fitzterra/kossel/BOM.ods

Kossel Bill of Materials
Printed Parts
Part | Qty | Cost | Done
Bottom Frame | 3 |  | 3
Top Frame | 3 |  | 3
Carriage | 3 |  | 3
Tower Slider | 3 |  | 3
Rod End Connectors | 12 |  | 12
Endstop | 3 |  | 3
End Effector | 1
Extruder | 1
Z-Probe | 1
Glass Tabs | 3
Rail Carriage | 3
Frame
Part – Mini | Qty | Cost | Done
600mm OpenBeam | 3
240mm OpenBeam | 9 |  |  |  | Lengths of 2m 1515 OpenBeam needed for XL
Borosilicate glass (170mm round) | 1 |  |  |  | Length | 650 | Remainder
 |  |  |  |  | 2000 | 3 | 50
Part – XL | Qty | Cost | Done |  | 2000 | 0 | 2000
650 mm OpenBeam (XL uses 750) | 3 | 0 | 3 | Ordered from Communica on 27/01/2015. Should be here by 10/02 |  | 360
360 mm OpenBeam | 9 | 982.6 | 9 |  | 2000 | 5 | 200
Borosilicate glass (250mm round) | 1 |  |  |  | 1250 | 3 | 170
 |  |  |  |  | 2000 | 5 | 200
Nuts & Bolts |  |  |  |  | 3 lengths @ R310/length from Communica
M2.5×12 | 1
M2.5×16 (plus 1 spare) | 10
M3×6 (you can do with half but this is for every hole) | 50
M3×8 (you need about 63 so enough spares) | 100
M3×16 (plus 1 spare) | 1
M3×20 (plus 2 spare) | 6
M3×25 (plus 3 spare) | 12
M3×35 (we don’t use it for tensioning but you may choose to do otherwise) | 3
M3 Nut (you need most of them) | 100
M3 Nyloc nut (plus 1 spare) | 1
M3 washer (you need about 60 of them) | 100
M4×20 grub screw (plus 3 spare) | 12
M5×20 | 1
M5 Nyloc nut | 1
M5 washer | 1
Linear Motion
Dual 623 V-rollers | 9
GT2 belt +-1400mm per slide | 3 | 76.5 | 3
GT2 Idler Wheel ( http://builda3dprinter.eu uses 2 x F623ZZ flanged bearings) | 3 | 105.3 | 3
GT2 Pulley 20 Teeth (16 teeth in kits from http://builda3dprinter.eu) | 3 | 42 | 3
NEMA17 stepper motor | 3 | 815.61 | 3
Diagonal Push Rods
Carbon Fibre rods – ID:4mm, OD:6mm, L:280mm | 6 | 270 | 6
Traxxas 5347 Ball ends | 12 | 73 | 12
Bowden Extruder
Hot End
Elecronics
Geetech GT2560 + DRV8825 Driver + LCD2004 Kit | 1 | 700
Fastners
M3 x 8 nut | 50 | 6.5
M3 x 8 hex bolt | 50 | 9
