fitzterra/kossel/stl.origs/extruder.stl

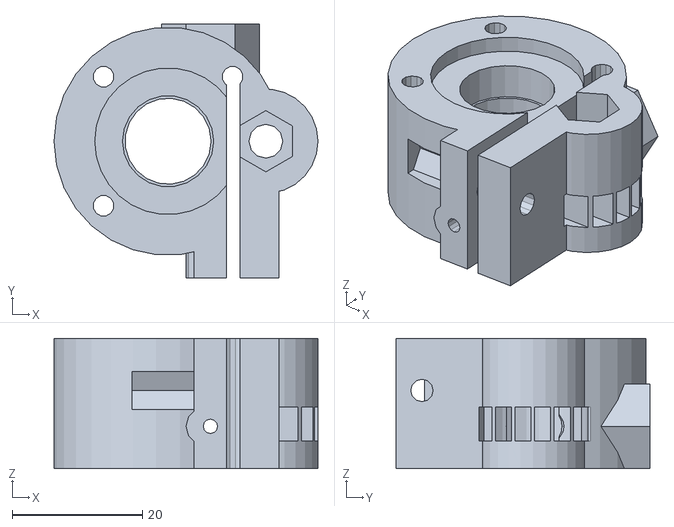
[picture p1: CAD file, 2016-03-02]
stl.origs/extruder.stl
40.5 x 39.0 x 20.0
