fitzterra/kossel/vbuild/ExtruderMotorBowdenMount.stl

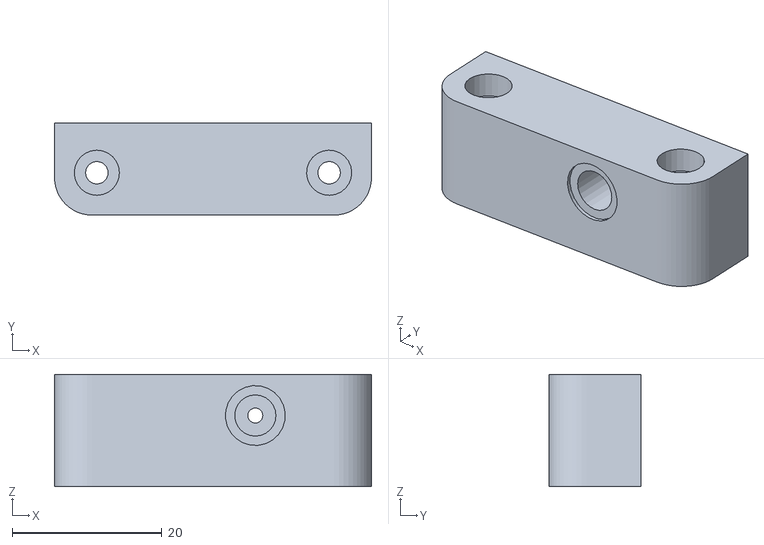
[picture p2: CAD file, 2017-05-16]
vbuild/ExtruderMotorBowdenMount.stl
42.3 x 12.3 x 15.0
