fitzterra/kossel/stl.origs/switch_holder.stl

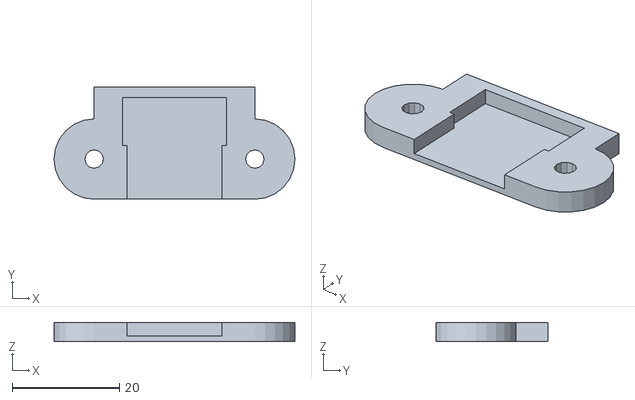
[picture p3: CAD file, 2016-03-02]
stl.origs/switch_holder.stl
45.0 x 21.0 x 3.60
