fitzterra/kossel/vbuild/ControlKnob.stl

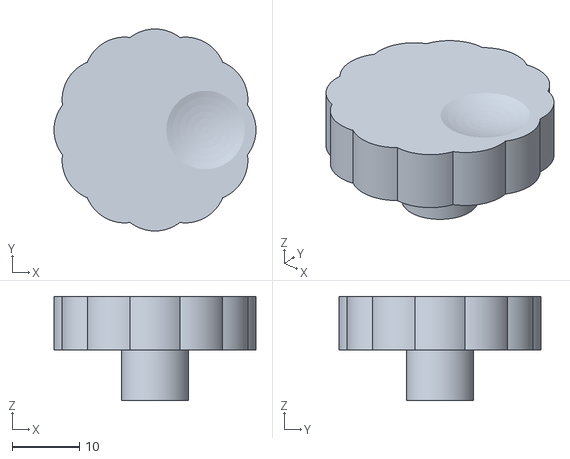
[picture p4: CAD file, 2017-05-16]
vbuild/ControlKnob.stl
30.0 x 30.0 x 15.5
