fitzterra/kossel/stl.origs/glass_frame.stl

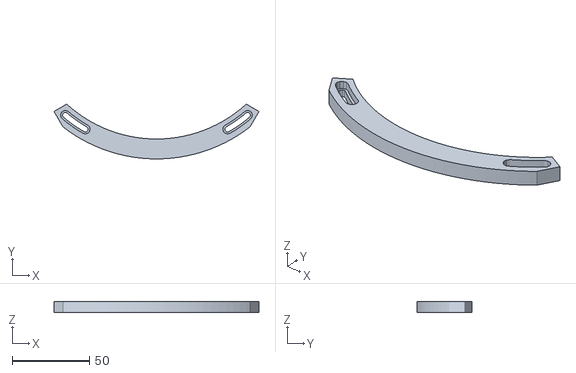
[picture p5: CAD file, 2016-03-02]
stl.origs/glass_frame.stl
132.8 x 35.5 x 7.35
