fitzterra/kossel/vbuild/EndstopWireGuide.stl

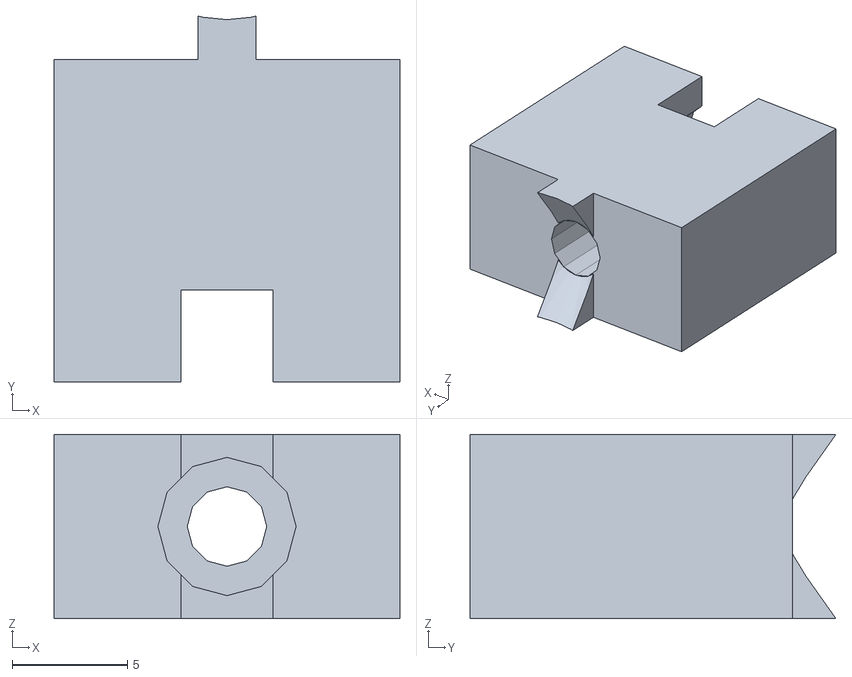
[picture p6: CAD file, 2016-06-09]
vbuild/EndstopWireGuide.stl
15.0 x 15.9 x 8.00
