fitzterra/kossel/stl.origs/card.stl

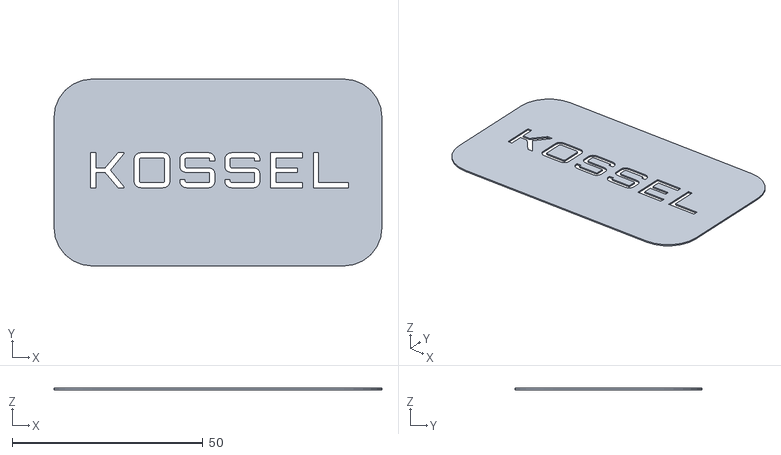
[picture p7: CAD file, 2016-03-02]
stl.origs/card.stl
86.0 x 49.0 x 0.4
