fitzterra/kossel/vbuild/rod_connector_hex.stl

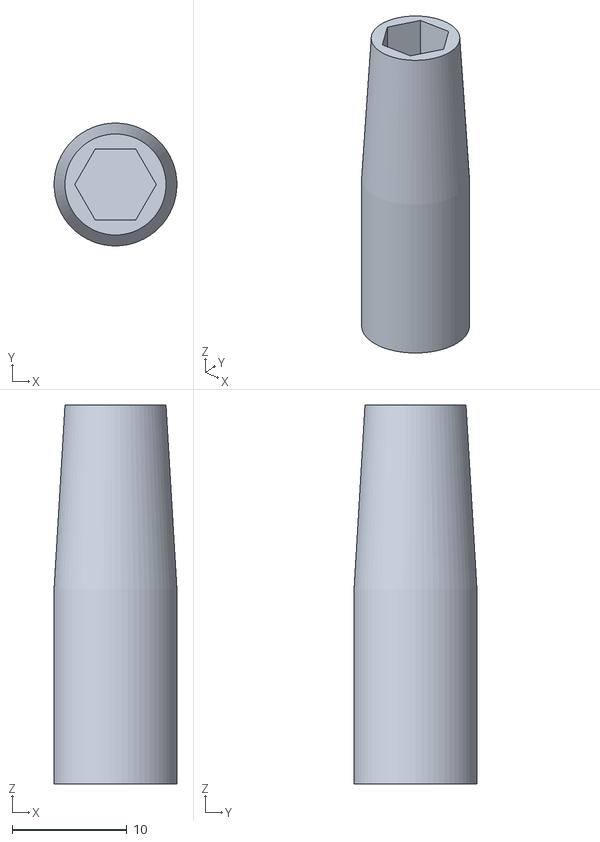
[picture p8: CAD file, 2016-06-09]
vbuild/rod_connector_hex.stl
10.7 x 10.7 x 33.0
