fitzterra/kossel/stl.origs/frame_top.stl

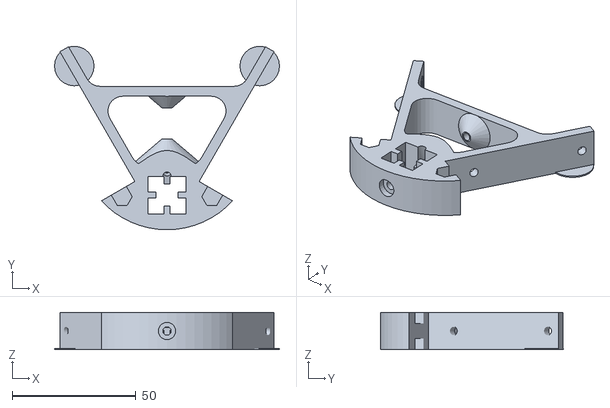
[picture p9: CAD file, 2016-03-02]
stl.origs/frame_top.stl
91.0 x 74.2 x 15.0
