fitzterra/kossel/vbuild/rod_cut_jig.stl

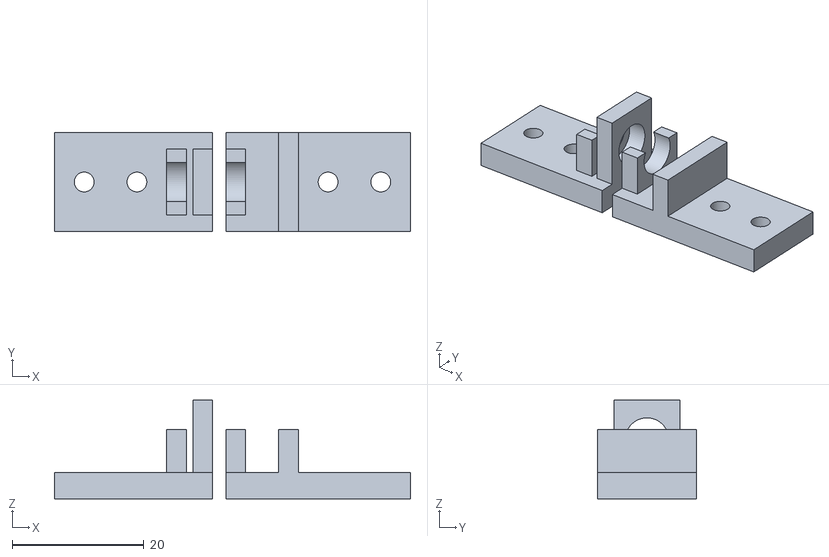
[picture p10: CAD file, 2016-04-04]
vbuild/rod_cut_jig.stl
54.0 x 15.0 x 15.0
