fitzterra/kossel/stl.origs/effector.stl

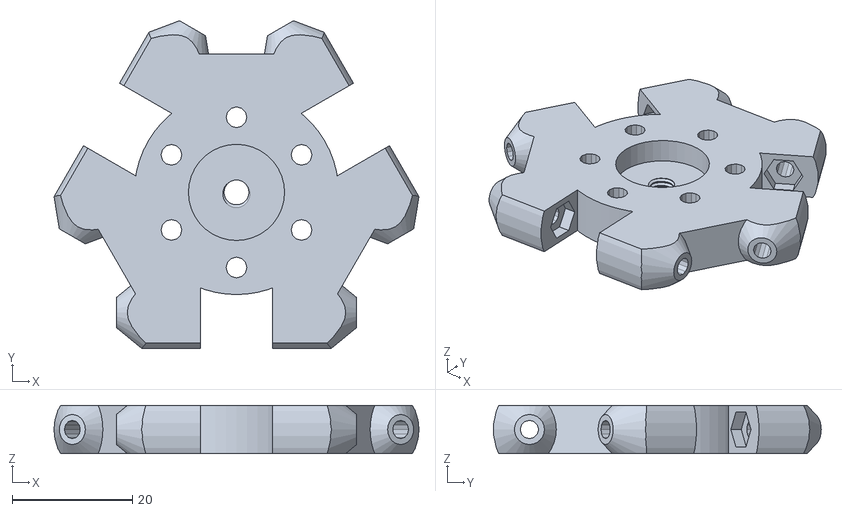
[picture p11: CAD file, 2016-03-02]
stl.origs/effector.stl
60.7 x 54.5 x 8.00
