fitzterra/kossel/vbuild/rod_end_jig.stl

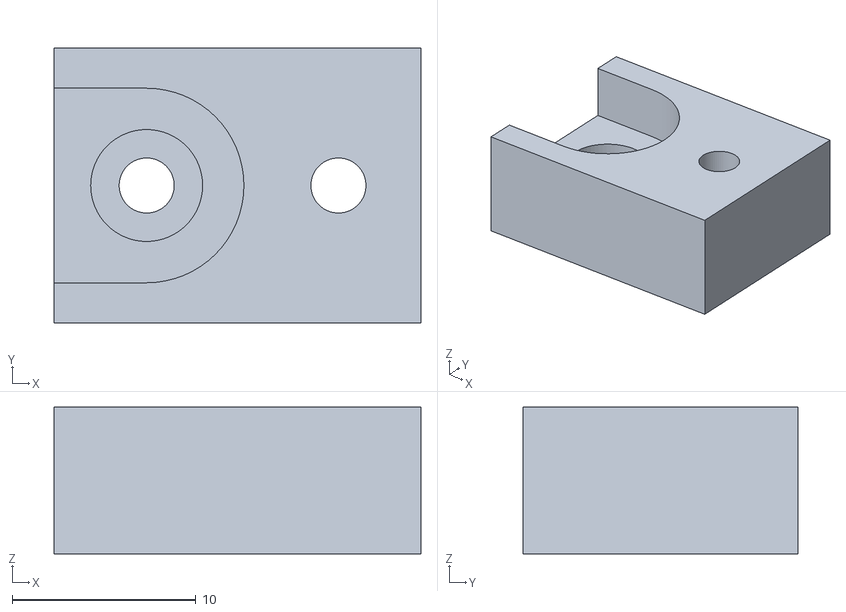
[picture p12: CAD file, 2016-04-04]
vbuild/rod_end_jig.stl
20.0 x 15.0 x 8.00
