fitzterra/kossel/stl.origs/glass_tab.stl

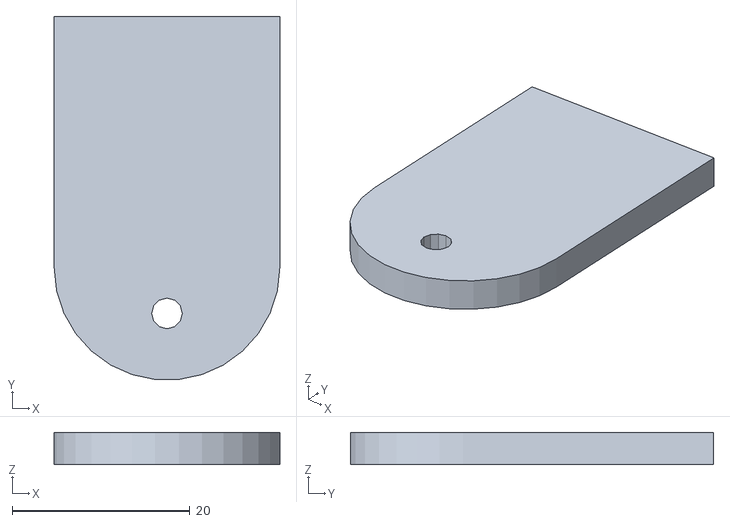
[picture p13: CAD file, 2016-03-02]
stl.origs/glass_tab.stl
25.4 x 40.8 x 3.60
