fitzterra/kossel/vbuild/traxxas-5347-joint.stl

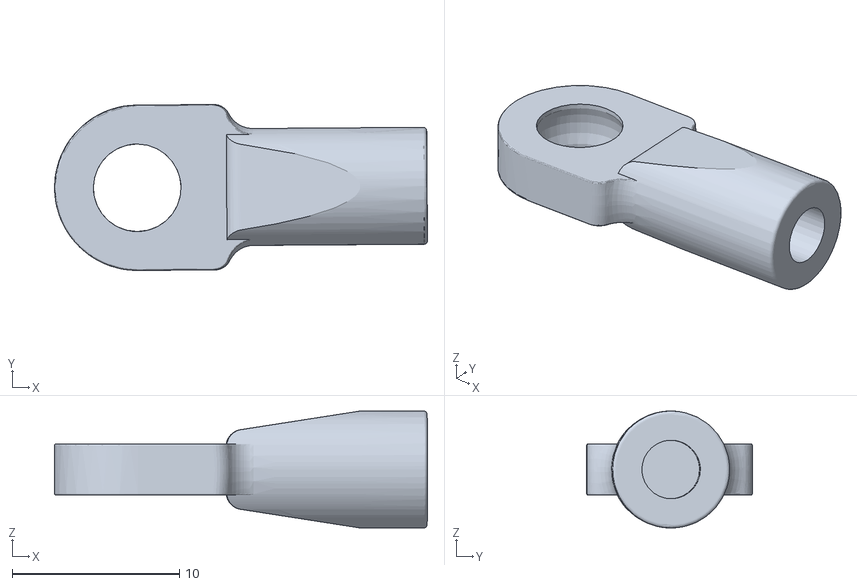
[picture p14: CAD file, 2016-04-04]
vbuild/traxxas-5347-joint.stl
22.3 x 9.93 x 7.00
