fitzterra/kossel/stl.origs/endstop.stl

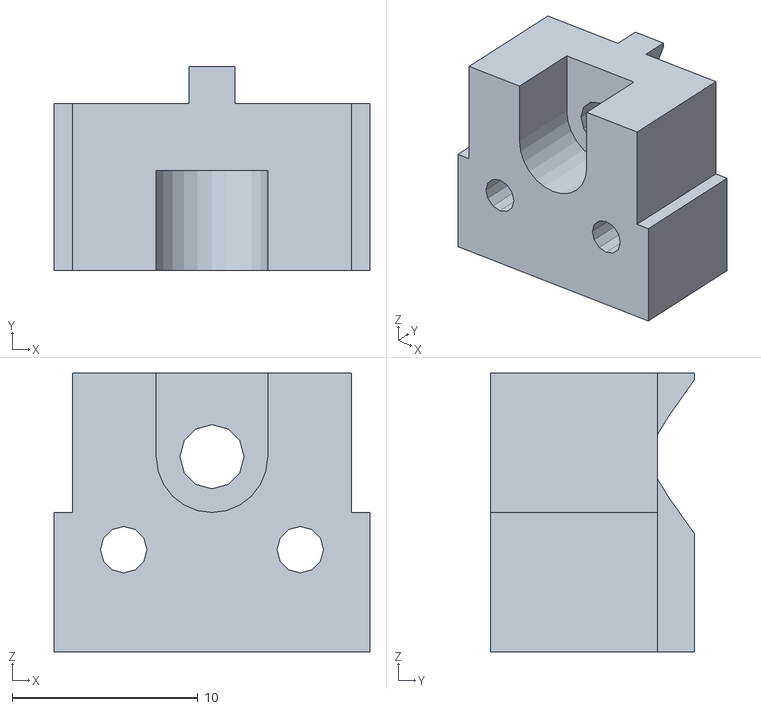
[picture p15: CAD file, 2016-03-02]
stl.origs/endstop.stl
17.0 x 11.0 x 15.0
