fitzterra/kossel/vbuild/traxxas-5347-ball.stl

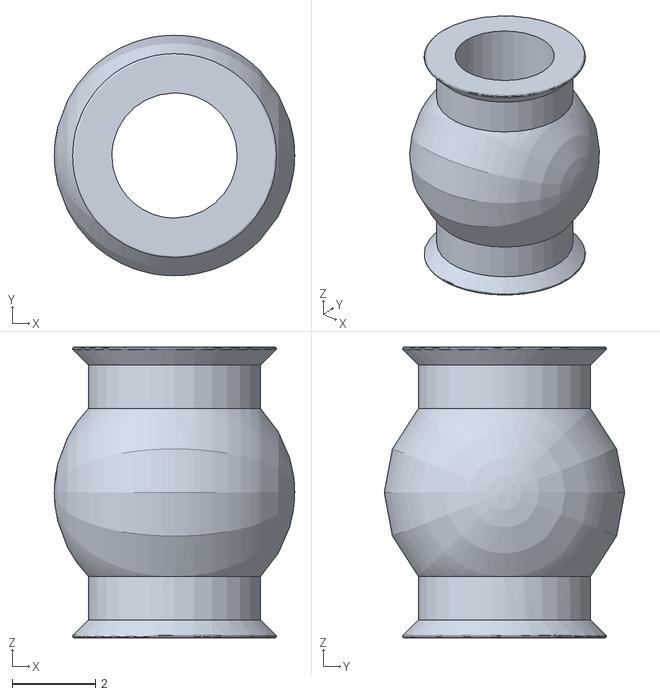
[picture p16: CAD file, 2016-04-04]
vbuild/traxxas-5347-ball.stl
5.77 x 5.77 x 6.98
