fitzterra/kossel/stl.origs/hotend_fan.stl

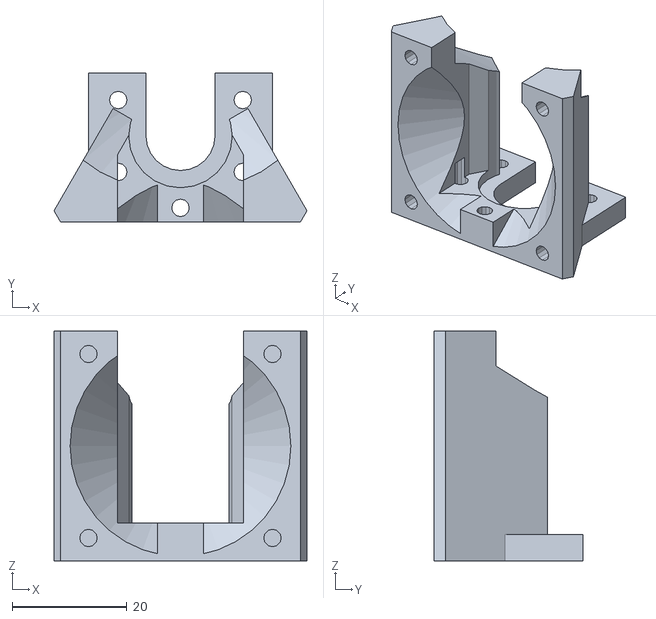
[picture p17: CAD file, 2016-03-02]
stl.origs/hotend_fan.stl
44.0 x 26.0 x 40.0
