fitzterra/kossel/vbuild/Traxxas5347.stl

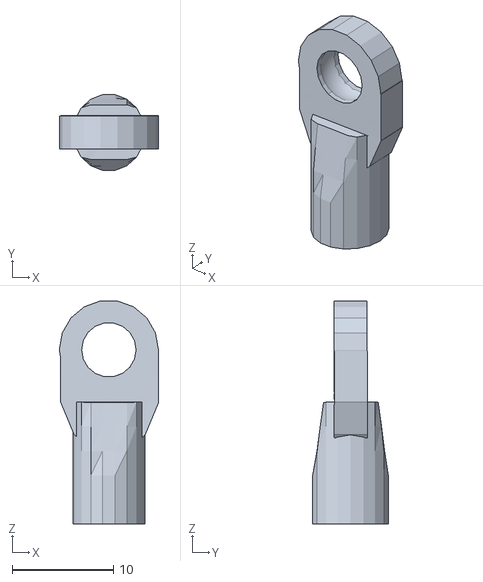
[picture p18: CAD file, 2016-03-29]
vbuild/Traxxas5347.stl
9.81 x 7.47 x 22.0
