fitzterra/kossel/stl.origs/carriage_recirculating.stl

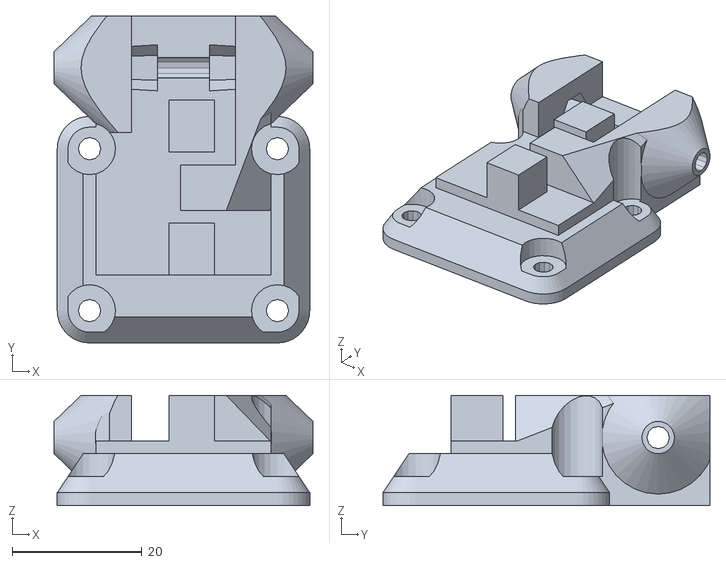
[picture p19: CAD file, 2016-03-02]
stl.origs/carriage_recirculating.stl
40.0 x 50.5 x 17.0
