fitzterra/kossel/vbuild/1515_1000mm.stl

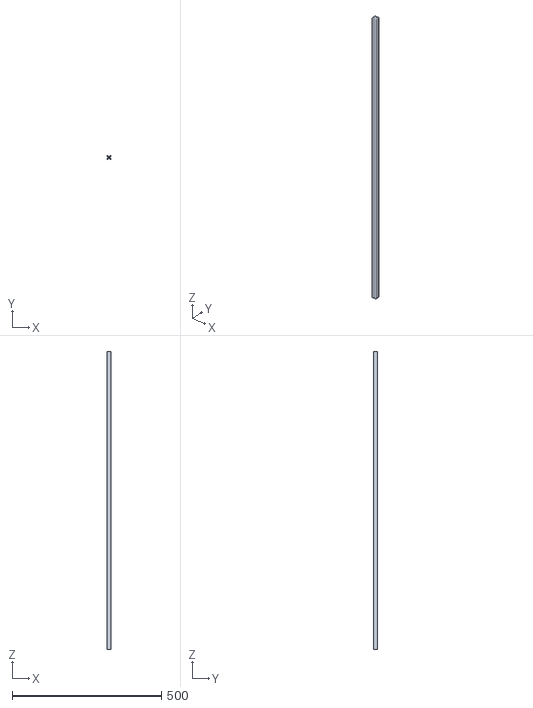
[picture p20: CAD file, 2016-03-29]
vbuild/1515_1000mm.stl
15.0 x 15.0 x 1000.0
