fitzterra/kossel/stl.origs/frame_motor.stl

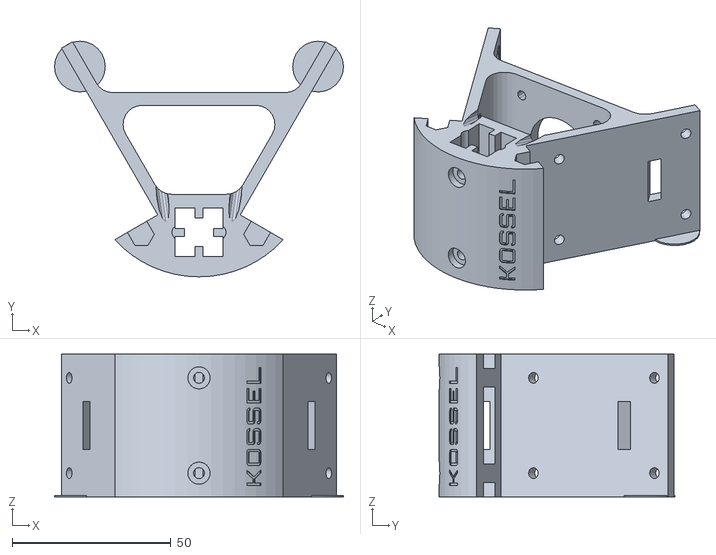
[picture p21: CAD file, 2016-03-02]
stl.origs/frame_motor.stl
91.0 x 74.2 x 45.0
