fitzterra/kossel/stl.origs/logotype.stl

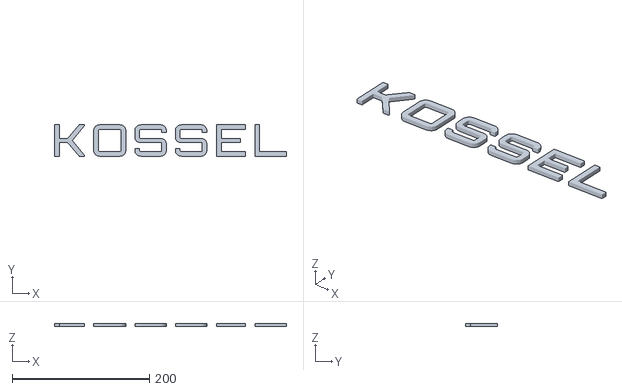
[picture p22: CAD file, 2016-03-02]
stl.origs/logotype.stl
338.0 x 46.0 x 5.00
