fitzterra/kossel/stl.origs/power_supply.stl

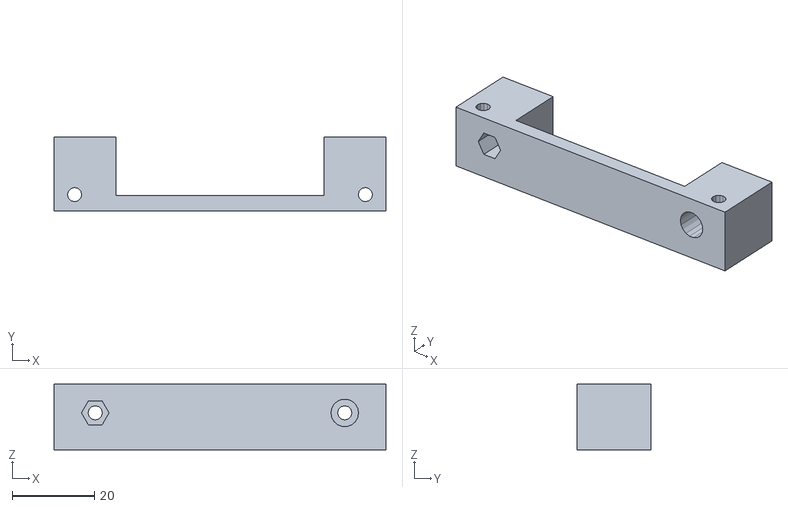
[picture p23: CAD file, 2016-03-02]
stl.origs/power_supply.stl
80.5 x 18.0 x 16.0
