fitzterra/kossel/stl.origs/plate_3x.stl

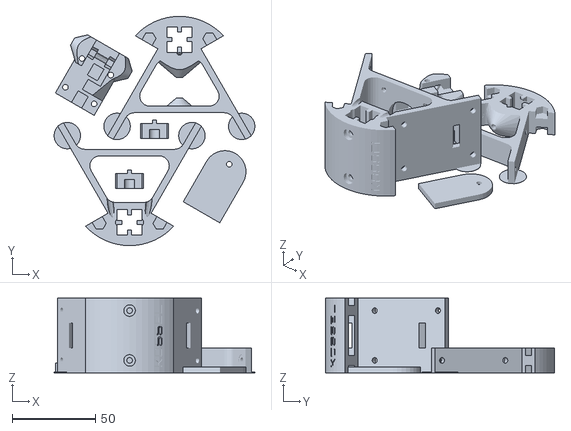
[picture p24: CAD file, 2016-03-02]
stl.origs/plate_3x.stl
121.0 x 138.0 x 45.0
