fitzterra/kossel/stl.origs/plate_1x.stl

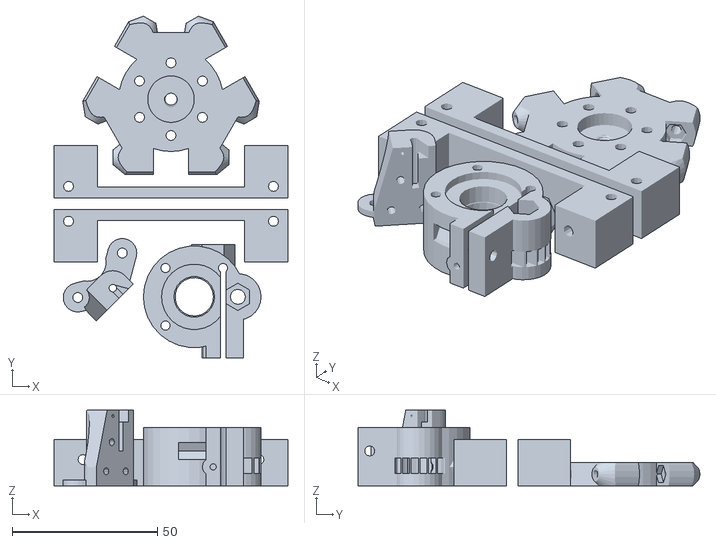
[picture p25: CAD file, 2016-03-02]
stl.origs/plate_1x.stl
80.5 x 117.6 x 26.0
