fitzterra/kossel/stl.origs/frame_extruder.stl

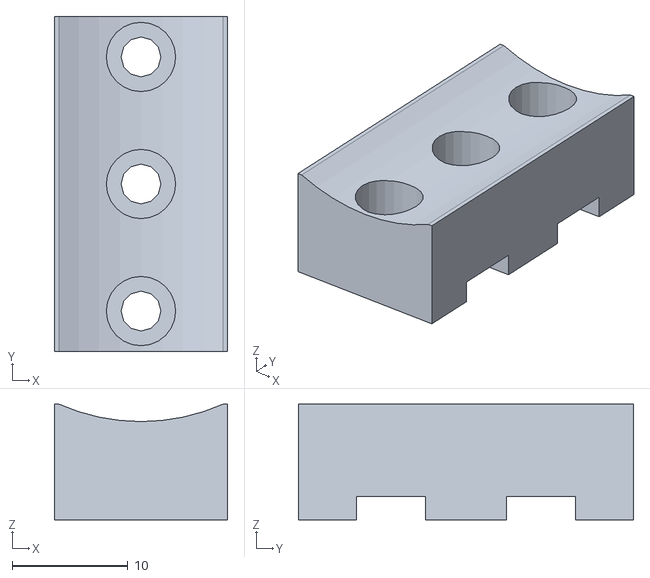
[picture p26: CAD file, 2016-03-02]
stl.origs/frame_extruder.stl
15.0 x 29.0 x 10.0
