fitzterra/kossel/stl.origs/retractable.stl

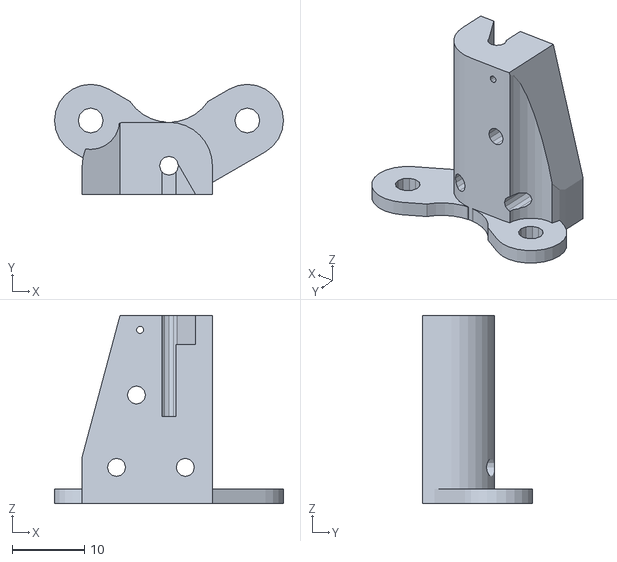
[picture p27: CAD file, 2016-03-02]
stl.origs/retractable.stl
31.7 x 15.2 x 26.0
