fitzterra/kossel/stl.origs/carriage.stl

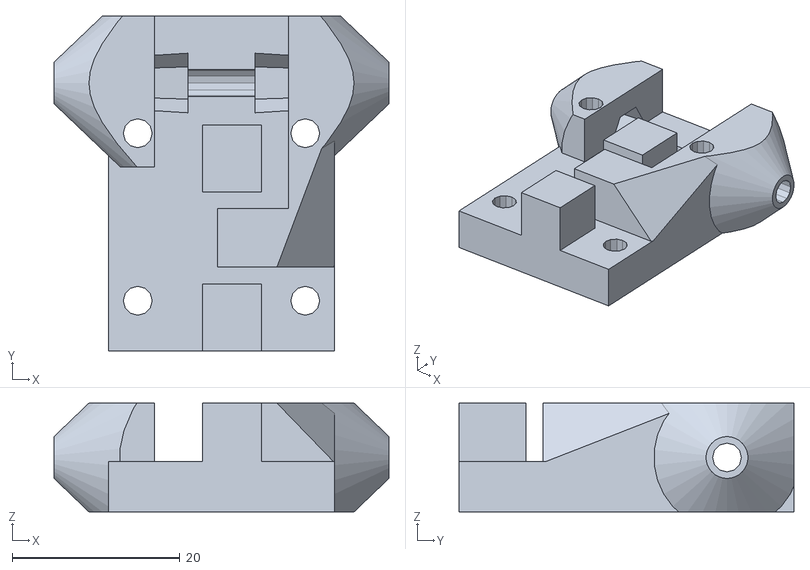
[picture p28: CAD file, 2016-03-02]
stl.origs/carriage.stl
40.0 x 40.0 x 13.0
