fitzterra/kossel/stl.origs/m5_internal.stl

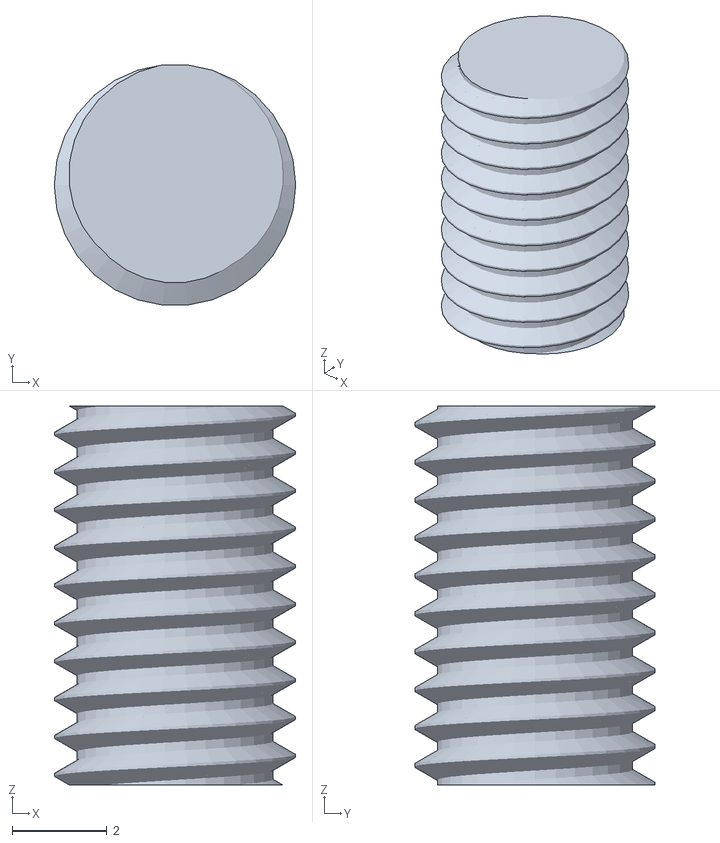
[picture p29: CAD file, 2016-03-02]
stl.origs/m5_internal.stl
5.10 x 5.07 x 8.00
