fitzterra/kossel/e3d_v6_all_metall_hotend.scad

/*
Name: E3D-v6 All Metal HotEnd in OpenSCAD
Author: Jons Collasius from Germany/Hamburg

License: CC BY-NC-SA 4.0
License URL: https://creativecommons.org/licenses/by-nc-sa/4.0/

Creator of "E3D-v6 All Metal HotEnd": E3D Online - JR 
URL E3D v6: http://wiki.e3d-online.com/wiki/E3D-v6_Documentation

Original Source: http://www.thingiverse.com/thing:548237/
Modified: Tom Coetser <fitzterra@gaul.za>
Changes: 
    * Reformatted to max 80 chars per line
    * Add the e3d_knockoff module with measurements from my chinese e3d v6 
      knockoff
    * Add option to rotate the hotend upright (default is on)
    * Removed old print function and replaced it with options to sample either
      of the two hotends, or none. The none option is useful if using "include"
      to use the hotend in another file. Best is to use the "use" option
      though.
*/

// ############################################################################

/* [Global] */
sample = "genuine";  // One of "none", "knockoff", "genuine"
sample = "knockoff";  // One of "none", "knockoff", "genuine"
//sample = "none";  // One of "none", "knockoff", "genuine"

// resolution of round object. each line segment is fnr mm long. fnr = 1 crude
// and good for development (its faster), aim for fnr = 0.4 or smaller for a
// production render. smaller means more details (and a lot more time to
// render).
fnresolution = 0.4;
// detail level
detaillevel = 1; // [0:coarse render only outlines,1:fine render with all details]

// ############################################################################
module e3d(upright=true) {
    rotate([0, upright?180:0, 0])
	difference() {
		union() {
			translate([0,0,0]) fncylinder(r=8,h=7);
			translate([0,0,6]) fncylinder(r=6,h=8);
			translate([0,0,13]) fncylinder(r=8,h=8);
			translate([0,0,20]) fncylinder(r=11.15,h=26);
			translate([0,0,0]) fncylinder(r=8,h=7);
			translate([0,0,45]) fncylinder(r=2,h=4.1);
			translate([-8,-4.5,48.1])
                chamfercube([16,20,11.5], 
                            side=[0.4,0.4,0.4,0.4],
                            top=[0.4,0.4,0.4,0.4],
                            bottom=[0.4,0.4,0.4,0.4]);
			translate([0,0,58.6]) fncylinder(r=2.5,h=3);
			translate([0,0,60.6]) fncylinder(r=4.03,h=3,fn=6);
			translate([0,0,62.6]) fncylinder(r=3,r2=0.5,h=3);
		}
		if(detaillevel==1) {
			translate([0,0,-1]) fncylinder(r=1.6,h=64.1);
			translate([0,0,62.1]) fncylinder(r=0.25,h=4,fn=10);
			translate([0,0,16]) fnpipe(r=9,r2=4.475,h=1.5); 
			translate([0,0,18.5]) fnpipe(r=9,r2=4.475,h=1.5); 
			for ( i = [0 : 9] ) {
				translate([0,0,21+i*2.5]) fnpipe(r=12.15,r2=4.475+i*0.15,h=1.5); 
			}
			translate([-9,8,55.6]) rotate([0,90,0]) fncylinder(r=3.05, h=18);
			translate([-9,8,54.6]) cube([18,8.5,2]);
			translate([0,13,47.1]) fncylinder(r=1.4, h=13.5);
			translate([4.45,-1,54.8]) rotate([0,90,0]) fncylinder(r=1.4, h=4.45);
			translate([3.45,-2.5,57.6]) rotate([0,90,0]) fncylinder(r=1.15, h=5.45);
		}
	}
}

module e3d_knockoff(upright=true, detaillevel=detaillevel) {
    rotate([0, upright?180:0, 0])
	difference() {
		union() {
			translate([0,0,0]) fncylinder(r=8,h=3.7);
			translate([0,0,3.7]) fncylinder(r=6,h=6);
			translate([0,0,3.7+6]) fncylinder(r=8,h=6.6);
			translate([0,0,3.7+6+6.6]) fncylinder(r=11.15,h=26);
			translate([0,0,3.7+6+6.6+26]) fncylinder(r=2,h=2.25);
			translate([-16/2,-11.15+7.05,3.7+6+6.6+26+2.25])
                chamfercube([16,20,12], 
                            side=[0.4,0.4,0.4,0.4],
                            top=[0.4,0.4,0.4,0.4],
                            bottom=[0.4,0.4,0.4,0.4]);
			translate([0,0,3.7+6+6.6+26+2.25+12-3]) fncylinder(r=2.5,h=3);
			translate([0,0,3.7+6+6.6+26+2.25+12]) fncylinder(r=3.98,h=2.5,fn=6);
			translate([0,0,3.7+6+6.6+26+2.25+12+2.5]) fncylinder(r=1.9,r2=0.5,h=1.75);
		}
		if(detaillevel==1) {
			translate([0,0,-1]) fncylinder(r=1,h=3.7+6+3.6+26+2.25+12+2.5);
			translate([0,0,3.7+6+6.6+26+2.25+12+2.5]) fncylinder(r=0.2,h=4,fn=10);
			translate([0,0,3.7+6+2.3]) fnpipe(r=9,r2=8-3.4,h=1.5); 
			translate([0,0,3.7+6+2.3+1.5+1.3]) fnpipe(r=9,r2=11.15-6.5,h=1.5); 
			for ( i = [0 : 9] ) {
				translate([0,0,3.7+6+6.6+1+i*2.5]) fnpipe(r=12.15,r2=11.15-6.3+i*0.22,h=1.5); 
			}
			translate([-9,-11.15+7.05+9.2+3.05,3.7+6+6.6+26+2.25+6.6])
                rotate([0,90,0]) fncylinder(r=3.05, h=18);
			translate([-9,-11.15+7.05+9.2+3.05,3.7+6+6.6+26+2.25+6.6-0.5])
			    cube([18,8.5,1]);
			translate([0,13,3.7+6+6.6+26+2.25-0.5]) fncylinder(r=1.4, h=13.5);
			translate([3.45,-2.0,3.7+6+6.6+26+2.25+8.7]) rotate([0,90,0]) fncylinder(r=1.15, h=5.45);
			translate([2.45,-1,3.7+6+6.6+26+2.25+5.6]) rotate([0,90,0]) fncylinder(r=1.4, h=6.45);
		}
	}
}

// ############################################################################
module chamfercube(xyz=[0,0,0], side=[0,0,0,0], top=[0,0,0,0], bottom=[0,0,0,0], 
                   x=false, y=false, z=false) {
	translate([x==true?-xyz[0]/2:0,y==true?-xyz[1]/2:0,z==true?-xyz[2]/2:0])
        difference() {
            cube(xyz);
            if(side[0]>=0)
                translate([0,0,xyz[2]/2])
                    rotate([0,0,45])
                        cube([side[0]*2,side[0]*3,xyz[2]+2],center=true);
            if(side[1]>=0)
                translate([xyz[0],0,xyz[2]/2])
                    rotate([0,0,-45])
                        cube([side[1]*2,side[1]*3,xyz[2]+2],center=true);
            if(side[2]>=0)
                translate([xyz[0],xyz[1],xyz[2]/2])
                    rotate([0,0,45])
                        cube([side[2]*2,side[2]*3,xyz[2]+2],center=true);
            if(side[3]>=0)
                translate([0,xyz[1],xyz[2]/2])
                    rotate([0,0,-45])
                        cube([side[3]*2,side[3]*3,xyz[2]+2],center=true);
            if(top[0]>=0)
                translate([xyz[0]/2,0,xyz[2]])
                    rotate([-45,0,0])
                        cube([xyz[0]+2,top[0]*2,top[0]*3,],center=true);
            if(top[2]>=0)
                translate([xyz[0]/2,xyz[1],xyz[2]])
                    rotate([45,0,0])
                        cube([xyz[0]+2,top[2]*2,top[2]*3,],center=true);
            if(top[3]>=0)
                translate([0,xyz[1]/2,xyz[2]])
                    rotate([0,45,0])
                        cube([top[3]*2,xyz[1]+2,top[3]*3,],center=true);
            if(top[1]>=0)
                translate([xyz[0],xyz[1]/2,xyz[2]])
                    rotate([0,-45,0])
                        cube([top[1]*2,xyz[1]+2,top[1]*3,],center=true);
            if(bottom[0]>=0)
                translate([xyz[0]/2,0,0])
                    rotate([45,0,0])
                        cube([xyz[0]+2,bottom[0]*2,bottom[0]*3,],center=true);
            if(bottom[2]>=0)
                translate([xyz[0]/2,xyz[1],0])
                    rotate([-45,0,0])
                        cube([xyz[0]+2,bottom[2]*2,bottom[2]*3,],center=true);
            if(bottom[3]>=0)
                translate([0,xyz[1]/2,0])
                    rotate([0,-45,0])
                        cube([bottom[3]*2,xyz[1]+2,bottom[3]*3,],center=true);
            if(bottom[1]>=0)
                translate([xyz[0],xyz[1]/2,0])
                    rotate([0,45,0])
                        cube([bottom[1]*2,xyz[1]+2,bottom[1]*3,],center=true);
        }	
}

// ############################################################################
module fnpipe(r,r2,h,fn){
	if (fn==undef) {
		difference() {
			fncylinder(r=r,h=h,$fn=2*r*3.14/fnresolution);
			translate([0,0,-1]) fncylinder(r=r2,h=h+2,$fn=2*r*3.14/fnresolution);
		}
	} else {
		difference() {
			fncylinder(r=r,h=h,fn=fn);
			translate([0,0,-1]) fncylinder(r=r2,h=h+2,fn=fn);
		}
	}
}

// ############################################################################
module fncylinder(r,r2,h,fn){
	if (fn==undef) {
		if (r2==undef) {
			cylinder(r=r,h=h,$fn=2*r*3.14/fnresolution);
		} else {
			cylinder(r=r,r2=r2,h=h,$fn=2*r*3.14/fnresolution);
		}
	} else {
		if (r2==undef) {
			cylinder(r=r,h=h,$fn=fn);
		} else {
			cylinder(r=r,r2=r2,h=h,$fn=fn);
		}
	}
}

// What to show
if(sample=="genuine")
    e3d();
else if(sample=="knockoff")
    e3d_knockoff();
