fitzterra/kossel/vbuild/tester.scad

color("limegreen", 0.1) import("../stl/tower_slides.stl"); //x-tower rail
translate([0, 0, 16])
rotate([90, 0, 180])
    import("../stl/carriage2.stl"); //x-tower rail
