fitzterra/kossel/(list of files, cad)

Other CAD files:
vbuild/BasePlate.skp
vbuild/ExtruderMotorBowdenMount.skp
vbuild/GeeeTech-LCDPanel+Bracket.skp
vbuild/Nema17.skp
vbuild/PSU+Brackets.skp
vbuild/z-probe-options.skp
