fitzterra/kossel/(commit log)

2016-02-29 Add BOM for my build, update ignore list.
    Ignoring the extra stuff from builda3dprinter.eu for now until I get a
    better feeling for what I can do with it.
    [BOM.ods]
2016-03-02 Repository reorganization
    * Move all STLs and GCode files into their own directories
    * Update Makefile to generate STLs and GCode in their respective dirs
    * Update Makefile to take STL dependancies into account for some SCAD
    files.
    * Update the SCAD files that import STLs to import them from the STL dir
    * Getting errors at the moment trying to clean the openscad exported
    STLs using meshlab server. Skipping this step for the moment, but
    keeping the original STLs from the upstream in the stl.origs dir.
    [card.scad, card.stl, carriage.stl, carriage_recirculating.stl, effector.scad, effector.stl, endstop.stl, extruder.stl]
2016-03-04 Add design for extruder sliders for linear motion.
    These can be used to replace the MGN12C linear sliders for a cheaper
    option.
    [tower_slides.scad]
2016-03-04 Comment and clean up code.
    Add first level comments to get a better understanding of the code used
    to draw the vertex.
    Fix indentation for better readability.
    [vertex.scad]
2016-03-29 Add virtual build files and new carraige.
    * Add new carriage with belt clamps and some mods for my setup.
    * Update Makefile to build new carriage2.scad
    * Add new virtual build dir (vbuild) in which my version of the delta
    bot is built virtually as each part is added/modified/designed.
    * Minor updates and comments to caaraige.scad and endstop.scad
    [1515_1000mm.stl, Traxxas5347.stl, carriage.scad, carriage2.scad, endstop.scad, kossel_1515.scad, tester.scad]
2016-04-04 Add jigs for cutting rods and attaching ball joints
    * Parameterized Cutting Jig:
    Consists of two parts that attach to an OpenBeam extrusion. One part
    acts as end guide and the other part as cut guide. Jigs allows easy
    measurement to get exact cut distance and then to simply slide a rod
    stock in, cut and repeat.
    Most parameters in the SCAD can be configured and there are options to
    show usage examples in the SCAD file too.
    * Parameterized Ends Join Jig:
    Two parts needs to be printed and attached to an OpenBeam extrusion.
    Each part is meant to fit the end of a Traxxas 5347 rod end joint, but
    should be adjustable for other Traxxas rod ends via the internal
    parameters.
    The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
    [rod_cut+end_jig.scad, rod_cut_jig.stl, rod_end_jig.stl, traxxas-5347-ball.stl, traxxas-5347-joint.stl]
2016-04-04 Add parametric rod end connector
    The rod end connector is meant to connect the a rod to the traxxas rod
    ends. It is configured for 6mm rods and traxxas 5347 rod ends, but all
    parameters should be modifyable.
    Make file updated to build STL for the connector.
    [rod_connector.scad]
2016-04-04 Update to Bill of Materials
    [BOM.ods]
2016-04-08 Add option for hex shaped ball joint connectors
    Some ball joint connectors may be hex shapedat the connection shaft side
    instead of round. This option is now supported.
    [rod_connector.scad]
2016-04-08 Add E3D type hotend effector option
    * Add an effector for E3D style hotends. This effector also brings the
    hotend nossle closer to the effector by raising the hotend up into the
    effector. This allows for higher prints.
    * Add a paramertric E3D type hotend OpenSCAD design to help with visual
    and virtual building.
    * Add a new M3 hole size for tapping to configuration.scad
    * Update the virtual build file to be able to select between the
    original and the new E3D effector.
    [configuration.scad, e3d-type-hotend.scad, effector_e3d.scad, kossel_1515.scad]
2016-04-14 Update electronics for BOM
    [BOM.ods]
2016-06-09 Modify Nema17 motor design and add PSU desing
    The nema17.scad now has an option to set the cap size which I needed for
    the motors I have.
    The PSU is a close model of the one I bought
    [PowerSupply.scad, nema17.scad]
2016-06-09 Updates to the virtual build
    * Many line reformats to get the line lengths below 80 chars
    * Since my rods were made a specific length, I force DELTA_DIAGONAL_ROD
    to 350 after it has been calculated as normal.
    * Update the frameHorizontal module to allow drawing the motors too.
    [kossel_1515.scad]
2016-06-09 Add some more parts for my build.
    * EndStopWireGuide - this is a guide to fit to the horizontal towers for
    the endstop wires. Since this build uses printed sliders on the frame,
    the wires can not be run inside the frame slots.
    * PSUSwitchBracket - brackets for holding a powerr socket and switch on
    the PSU body
    * rod_connector_hex - one of the rod ends I received has a hex form
    instead of the normal round. This stl is for a rod connector to fit
    this rod end.
    [EndstopWireGuide.scad, EndstopWireGuide.stl, PSUSwitchBracket.scad, PSUSwitchBracket.stl, rod_connector_hex.stl]
2016-06-09 Add some tests for getting to know the GT2560 board
2016-06-30 Add glass/buildplate mount tabs and penholder
    * Add parametric tabs to mount a buildplate or glass to the frame
    * Add a pen holder to mount to the eddector that can be used for
    drawing, etc.
    * Update effector_e3d.scad to generate separate STLs from any of it's
    modules and change Makefile to generate these STLs
    [effector_e3d.scad, glass_grip_tab.scad, kossel_1515.scad]
2016-06-30 Add detachable Z-Probe and other Z-Probe options
    * Add a magnetically attachable Z-Probe that sits in a cradle until
    needed. The effecor has a probe bar attached at the bottom that also
    has 2 magnets attached. To engage the Z-Probe, the effector moves over
    the probe in the cradle, attaches the probe and uses it. To detach the
    probe, it is moved into the cradle and the effector moves away in the
    same Z plane to detach the magnets. The magnets are also used as the
    electrical path to the microswitch terminals on the detachable probe.
    * Also including a sketchup file and OpenSCAD file for other z-probe
    options
    [z-probe-options.scad, z-probe-options.skp, z-probe_detachable.scad]
2016-07-04 LCD Panel and bracket and extender brackets for buildplate
    * BuildPlateBracket - a gusset and assembly for an extender bracket for
    the build plate which is slightly smaller than the frame.
    * GeeeTech-LCDPanel+Bracket - a sample of the LCD Panel and brackets
    that can be used to mount it to the frame. Can also show a sample
    assembly of the final bracket and LCD mounted to the bottom
    extrusions. THe Sketchup file was the first draft to rapidly design
    the bracket.
    [BuildPlateBracket.scad, GeeeTech-LCDPanel+Bracket.scad, GeeeTech-LCDPanel+Bracket.skp, kossel_1515.scad]
2016-08-09 Add a version 2 wire guide.
    This guide can manage a few strands ribbon cable in side slots as used
    for the endstops and other thinner wires, as well as thicker cabling
    down the center. This is mostly used on the Z tower where main cabling
    would be run down from the top.
    [EndstopWireGuide.scad]
2016-08-09 Improvements to PSU simulation and mounting bracket.
    * Improve the drawing of the PSU based on better measurements.
    * Add mounting brackets to mount the PSU upright to the back of the Z
    tower. The brackets are based on the V2 EndStopWireGuide design.
    [PowerSupply.scad]
2016-08-09 Add some Sketchup files used for some design parts
    * Add a sample of how the base plate should look
    * Add a sketchup file used to figure out the PSU mounting brackets
    [BasePlate.skp, PSU+Brackets.skp]
2016-08-09 Add extruder cold end filament driver.
    This is a filament driver for a stepper recovered from and old printer
    and using a roller from and old hard drive.
    [ExtruderColdEnd.scad]
2017-05-16 Replace idler roller with bearing and some other improvements.
    [ExtruderColdEnd.scad]
2017-05-16 Power Supply bracket updates and new options
    * Add a V stype bracket as option for mounting the power supply
    * Incorporate the old PSUSwitchBracket.scad into PowerSupply.scad and
    remove PSUSwitchBracket
    [PSUSwitchBracket.scad, PSUSwitchBracket.stl, PowerSupply.scad]
2017-05-16 Modify posts to allow 30mm fan to be mounted.
    [effector_e3d.scad]
2017-05-16 Comment update
    [z-probe_detachable.scad]
2017-05-16 Add control knob for rotary encoder on panel
    [ControlKnob.scad, ControlKnob.stl]
2017-05-16 Experiment with SaintFeed type feeder on Nema23 stepper.
    Getting a proper tapered thread onto which the adjustment ring fits is
    proving to be a bit of a challange for my knowledge of threads. May dive
    into this at some later stage since the Saintfeed mechanism is a very
    nice design.
    [SaintFeed.scad, SynStepNEMA23.scad]
2017-05-16 Add Sketchup files for extruder motor mount.
    This is the bottom mount and filament path for the filament feeder on a
    Nema17 motor. It is drawn in sketchup and exported as STL from there.
    It seemed quicker to do it in SketchUp rather than OpenSCAD since the
    Nema model was available, and drawing the feeder size was measure
    directly. I needed this in a hurry, but should really be re-done in
    OpenSCAD at some point :-)
    The Nema17.skp file is from the 3D Warehouse.
    [ExtruderMotorBowdenMount.skp, ExtruderMotorBowdenMount.stl, Nema17.skp]
2017-05-18 Update effector to take a E3D v6 (clone) hotend.
    Add a model of the all metal E3D V6 hotend by Jons Collasius, with
    an additional module for a Chinese knockoff of the V6 using the sizes
    meassured from the knockoff hotend.
    The V6 is too short to fit above the effector, so positioning is
    different which required modifications to effector_e3d.scad to allow a
    clamp style fitting for the V6 hotend - the clamp idea was stolen from a
    similar idea off Thingivers - thanks!
    effector_e3d.scad still allows the old v5 hotend and fitting style, and
    can all be modified via parameters.
    The Makefile was updated to to auto make both the V5 and V6 style
    hotends and effectors.
    Also updated kossel_1515.scad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
    [e3d_v6_all_metall_hotend.scad, effector_e3d.scad, kossel_1515.scad]
2017-07-08 Add support for belt clips - they break too easily under stress
    [carriage2.scad]
2017-07-09 Improve belt installation for the carraige.
    [carriage2.scad]
2017-07-27 Add optionis for newer E3D hotend mount to effector.
    After damaging my E3D V5 (at least I think it is a V5) Chinese clone, I
    had to modify the effector to accept a newer V6 clone. Due to the fan
    duct on the newer hotend, I had to drop it down in the effector which
    required a new mount clamp and also detachable Z-Probe mounting.
    THe code is in a bit of a mess here and needs some clean up still.
    [effector_e3d.scad, z-probe_detachable.scad]
2017-07-27 Add new parts cooler fan duct.
    New fan duct based on a design by AndrewBCN on Thingiverse.
    The fan duct is almost fully configurable via the customizer option in
    newer versions of OpenSCAD or on Thingiverse. Only the actual duct path
    design has to be modified in code.
    Also modified effector_e3d.scad to see how the fan duct would fit in my
    effector configuration. Still needs to clean this up.
    [effector_e3d.scad, fan_duct.scad]
2017-08-02 Make configuration customizer friendly
    Reorganized rendering and parameter options to be customizer friendly.
    This allows the design and layout to be adjusted through the more
    friendly customzier interface with instant feedback.
    Everything is not 100% yet, but this is hughe start in the right
    direction.
    [effector_e3d.scad]
2017-12-30 Stronger Carraige2 belt clip.
    The carraige2 belt clip keeps breaking due to stress on the belt. Have
    already strenghtened this before by adding a fillet, but have now also
    made the smooth side that keeps breaking a bit thicker.
    [carriage2.scad]
